fivebot-printer/fivebot/README.md

# fivebot
The fivebot 3D printer project

For more info please refer to [the docs](https://fivebot-printer.github.io/fivebot/).
