fivebot-printer/fivebot/display/STLs/display-bracket_right_1.stl

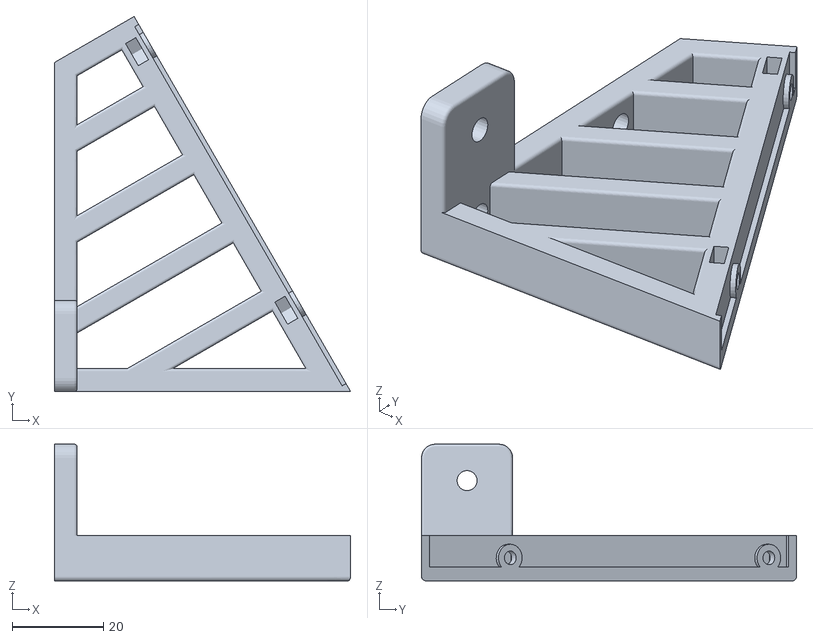
[picture p5: CAD file, 2023-12-28]
display/STLs/display-bracket_right_1.stl
65.0 x 82.3 x 30.0
