fivebot-printer/fivebot/dual-z/STLs/front-guide-rod-top-mount_1.stl

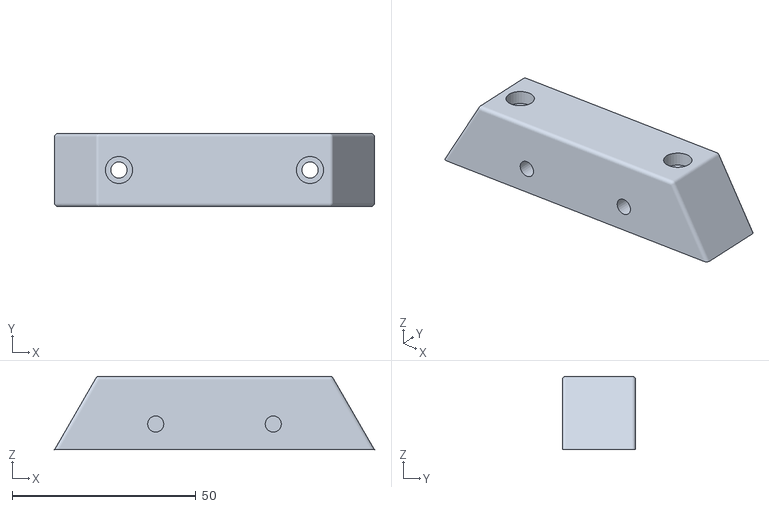
[picture p6: CAD file, 2023-12-28]
dual-z/STLs/front-guide-rod-top-mount_1.stl
87.1 x 20.0 x 20.0
