fivebot-printer/fivebot/display/STLs/display-front-panel_1.stl

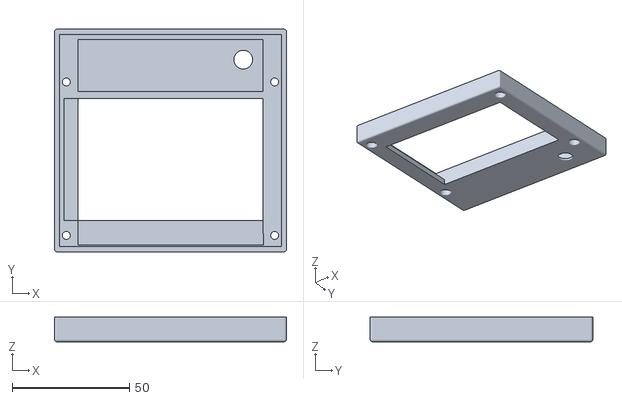
[picture p7: CAD file, 2023-12-28]
display/STLs/display-front-panel_1.stl
99.0 x 95.0 x 10.5
