fivebot-printer/fivebot/dual-z/STLs/rear-bed-mount_1.stl

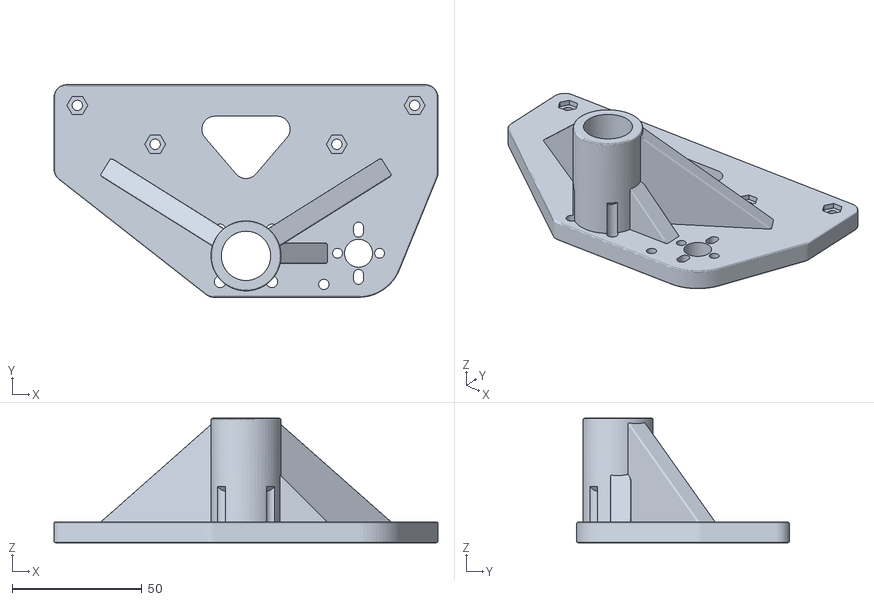
[picture p8: CAD file, 2023-12-28]
dual-z/STLs/rear-bed-mount_1.stl
148.0 x 82.0 x 48.0
