fivebot-printer/fivebot/dual-z/STLs/front-bed-mount_1.stl

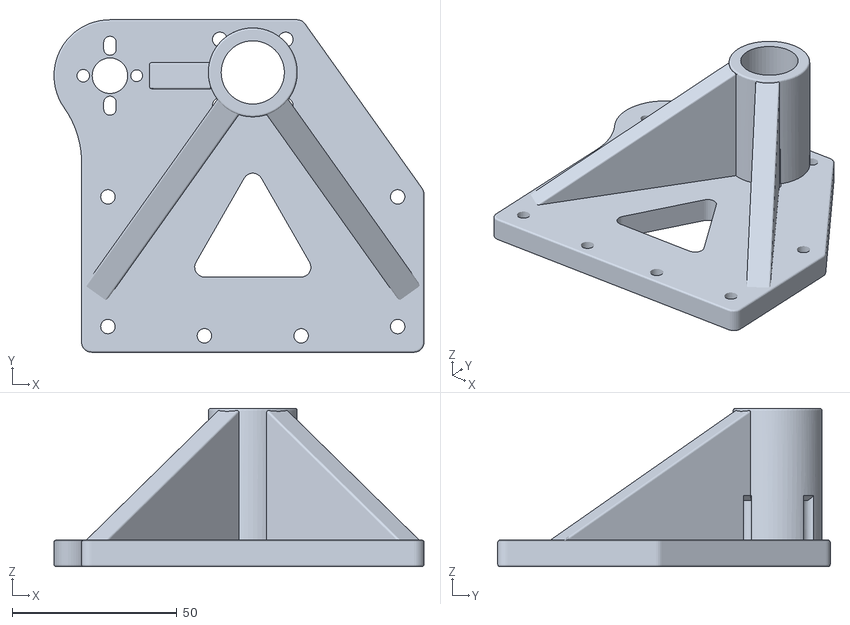
[picture p9: CAD file, 2023-12-28]
dual-z/STLs/front-bed-mount_1.stl
112.4 x 101.0 x 48.0
