fivebot-printer/fivebot/dual-z/STLs/electronics-enclosure-mount-a_2.stl

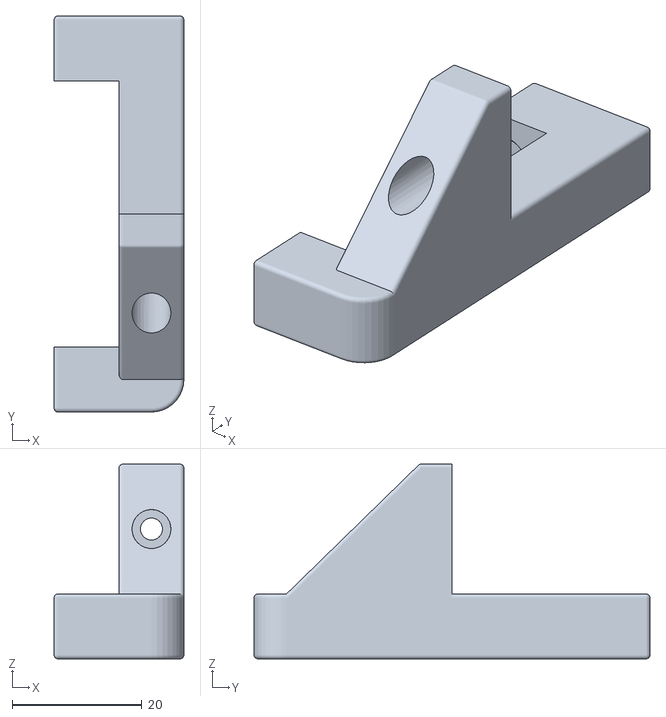
[picture p10: CAD file, 2023-12-28]
dual-z/STLs/electronics-enclosure-mount-a_2.stl
20.0 x 61.0 x 30.0
