fivebot-printer/fivebot/dual-z/STLs/motor-bracket_2.stl

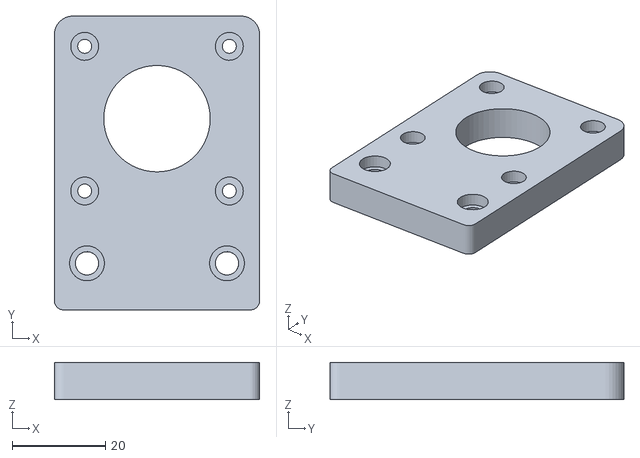
[picture p11: CAD file, 2023-12-28]
dual-z/STLs/motor-bracket_2.stl
44.0 x 63.0 x 8.00
