fivebot-printer/fivebot/dual-z/STLs/front-bed-mount-bracket_1.stl

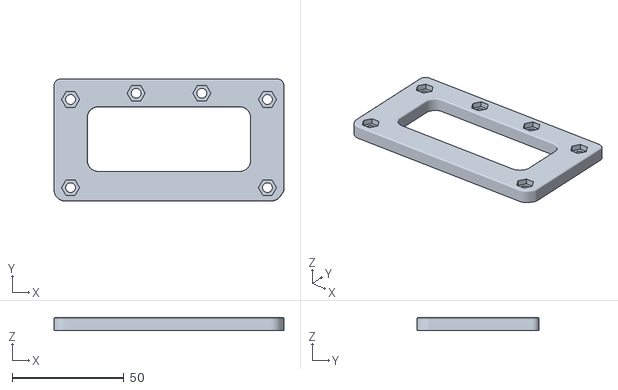
[picture p12: CAD file, 2023-12-28]
dual-z/STLs/front-bed-mount-bracket_1.stl
102.8 x 54.6 x 6.00
