fivebot-printer/fivebot/(list of files, cad)

Other CAD files:
display/STLs/display-bracket_left_1.stl
dual-z/STLs/electronics-enclosure-mount-b_2.stl
dual-z/STLs/motor-bracket-thrust-bearing_2.stl
