fivebot-printer/fivebot/(commit log)

2023-12-17 dual-z mod beta version
    [front-bed-mount-bracket_1.stl, front-bed-mount_1.stl, front-guide-rod-top-mount.stl, main-board-mount-a_2.stl, main-board-mount-b_2.stl, motor-bracket-stock_2.stl, motor-bracket_2.stl, rear-bed-mount_1.stl]
2023-12-19 added motor mount with thrust bearing support
    [motor-bracket-thrust-bearing.stl]
2023-12-20 improved thrust bearing motor bracket
    [motor-bracket-thrust-bearing.stl, motor-bracket-thrust-bearing_2.stl]
2023-12-21 added thrust bearing bracket image
2023-12-21 display mount files
    [display-bracket_left_1.stl, display-bracket_right_1.stl, display-front-panel_1.stl]
2023-12-23 improved guide rod mount
    [front-guide-rod-top-mount.stl, front-guide-rod-top-mount_1.stl]
2023-12-25 added drop in M3 hex nuts to display brackets
    [display-bracket_left_1.stl, display-bracket_right_1.stl]
2023-12-28 minor tweak of display brackets and all STLs oriented for printing
    [display-bracket_left_1.stl, display-bracket_right_1.stl, display-front-panel_1.stl, electronics-enclosure-mount-a_2.stl, electronics-enclosure-mount-b_2.stl, front-bed-mount-bracket_1.stl, front-bed-mount_1.stl, front-guide-rod-top-mount_1.stl]
